Sandman6z/MVEPP_MainSensor/Doc/MVEPP_传感器接口定义.docx

O2 传感器接口定义

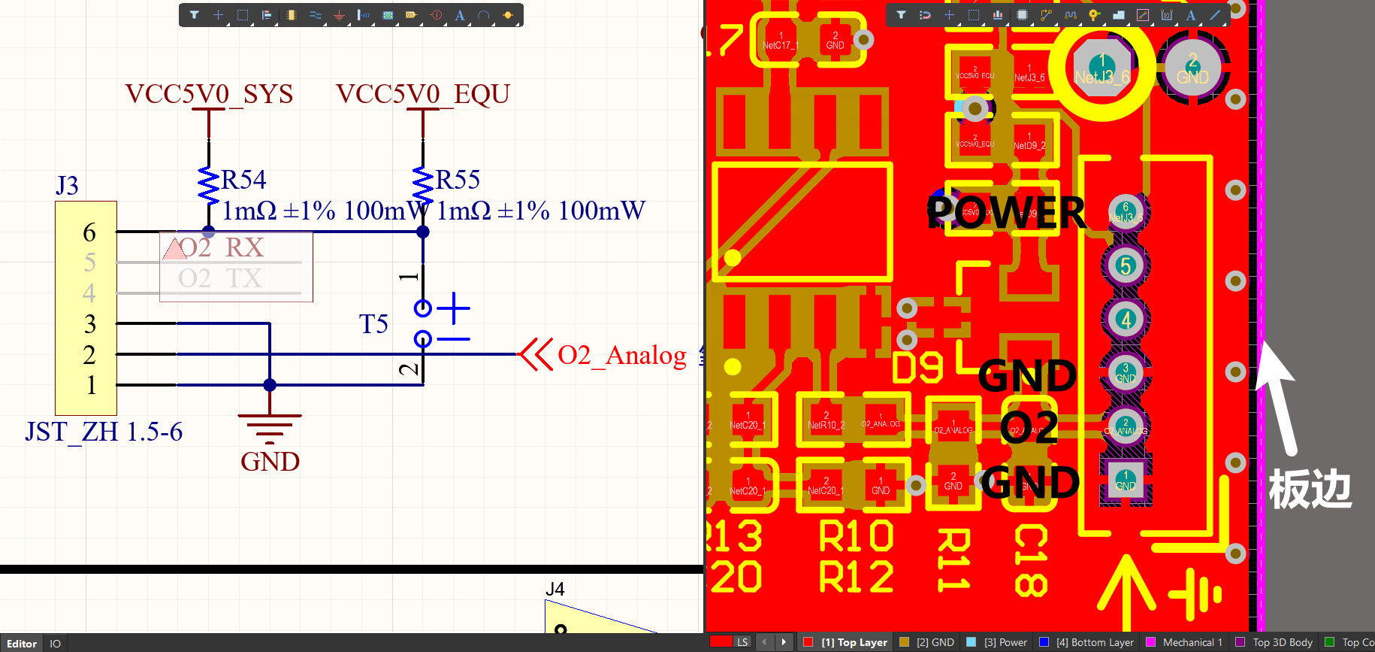
[picture p1: figure]

TSI

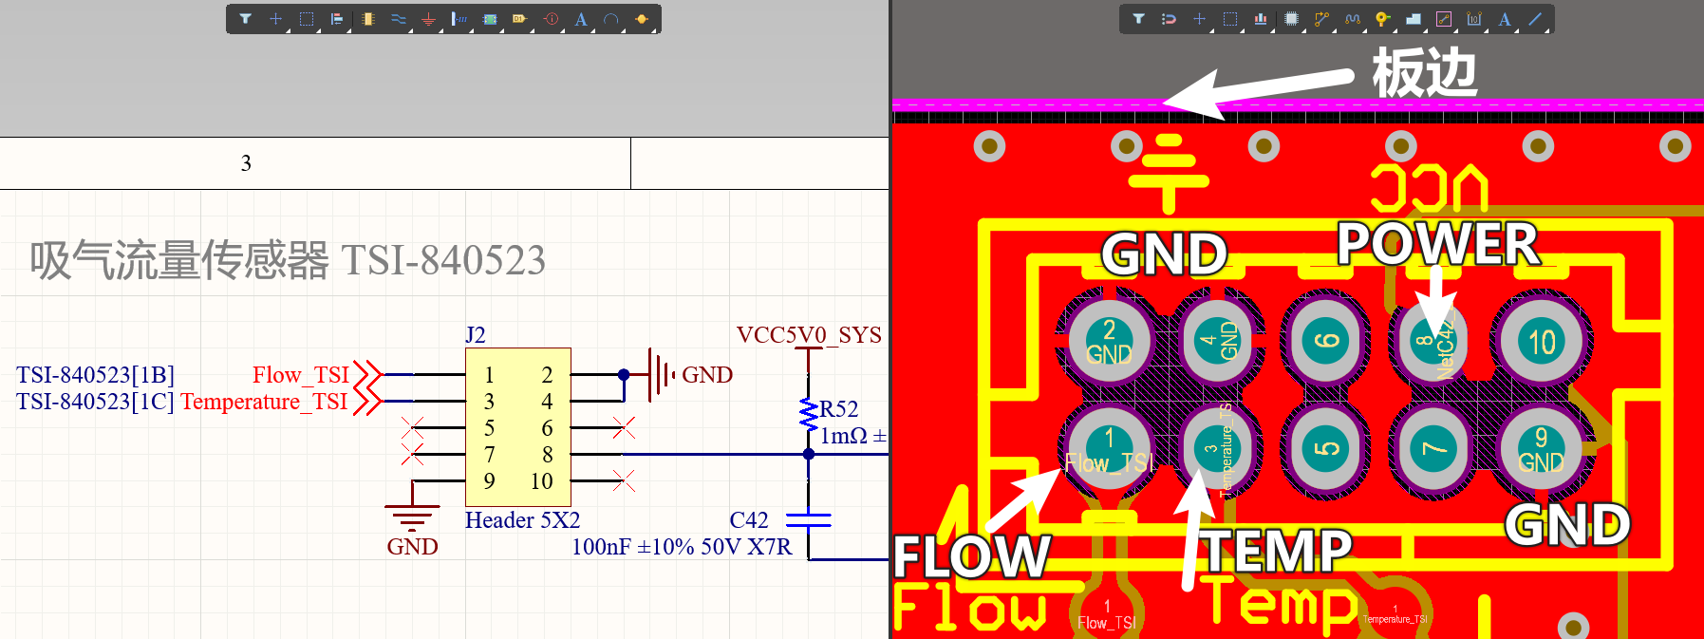
[picture p2: figure]

3100

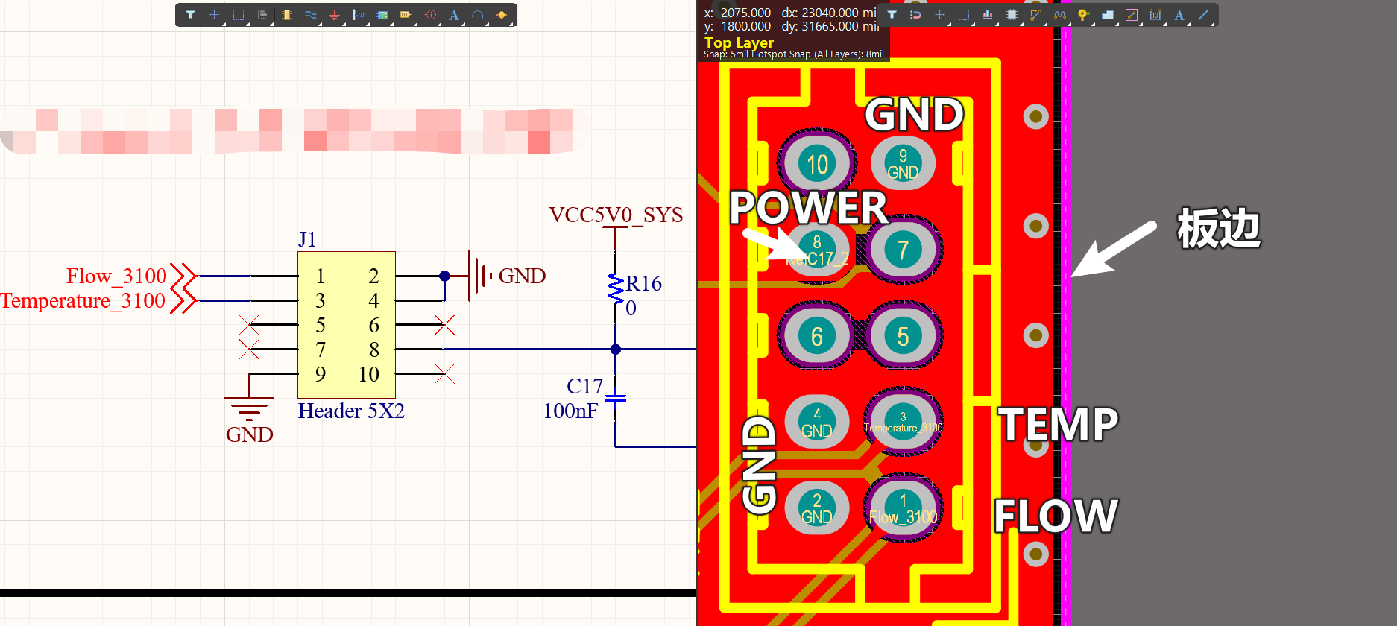
[picture p3: figure]
