Sandman6z/MVEPP_MainSensor/Doc/通气预研平台硬件设计-传感器物料编号.xlsx

元件编号 | 元件名称 | 元件型号 | 物料号 | 数量(单套) | 需申领数量
1 | 氧流量传感器 | SFM-3100 | 240001459 | 1 | 1*2
2 | 氧浓度传感器 | MOX-4 | 210001975 | 1 | 1*2
3 | 低压压力传感器 | HoneyWell-HSCDRRN160MDAA5 | 210004934 | 3 | 3*2
4 | 流量传感器 | TSI-8405xx | 452005747 | 1 | 1*2
5 | 微压差传感器 | HoneyWell-HSCDRRN002NGAA5 | 210004197 | 1 | 0
6 | 环境压力传感器 | MPXHZ6115AC6U | 210001798 | 1 | 1*2
7 | 高压压力传感器 | HoneyWell-ABPLLNT010BGAA5 | 210004930 | 1 | 0
