Sandman6z/MVEPP_MainSensor/(list of files, drawings)

Other design files:
452007098_MVEPP主传感器板.PrjPcb
IO.SchDoc
LED.SchDoc
Others.SchDoc
OxygenSensor.SchDoc
Power&Vref.SchDoc
PressSensor1.SchDoc
PressSensor2.SchDoc
Top.SchDoc
TSI-840523.SchDoc
框图.SchDoc
