Sandman6z/MVEPP_MainSensor/(commit log)

2024-04-26 Original files.
    [452006257#BDU控制板0-框图.SchDoc, 452006257#BDU控制板1-电源.SchDoc, 452006257#BDU控制板2-单片机.SchDoc, 452006257#BDU控制板3-功能安全.SchDoc, 452006257#BDU控制板4-通讯接口.SchDoc, 452006257#BDU控制板5-传感器.SchDoc, 452006257#BDU控制板6-传感器及外部AD.SchDoc, 452006257#BDU控制板7-执行部件.SchDoc]
2024-04-26 adjust files
    [452006257#BDU控制板1-电源.SchDoc, 452006257#BDU控制板2-单片机.SchDoc, 452006257#BDU控制板3-功能安全.SchDoc, 452006257#BDU控制板4-通讯接口.SchDoc, 452006257#BDU控制板5-传感器.SchDoc, 452006257#BDU控制板PCBA.PrjPcb, 压力传感器.SchDoc, 基准.SchDoc]
2024-04-29 adjust part of request
    [452006257#BDU控制板1-电源.SchDoc, 452006257#BDU控制板4-通讯接口.SchDoc, 452006257#BDU控制板5-传感器.SchDoc, 452006257#BDU控制板6-传感器及外部AD.SchDoc, 452006257#BDU控制板7-执行部件.SchDoc, 452006257#BDU控制板PCBA.PrjPcb, 基准.SchDoc, 氧传感器.SchDoc]
2024-04-30 adjust part
    [452006257#BDU控制板1-电源.SchDoc, 452006257#BDU控制板4-通讯接口.SchDoc, 452006257#BDU控制板6-传感器及外部AD.SchDoc, TSI-840523.SchDoc, 基准.SchDoc, 氧传感器.SchDoc, 氧浓度传感器.SchDoc, 电源及基准.SchDoc]
2024-05-07 go on
    [452006257#BDU控制板1-电源.SchDoc, 452006257#BDU控制板2-单片机.SchDoc, 452006257#BDU控制板3-功能安全.SchDoc, 452006257#BDU控制板4-通讯接口.SchDoc, 452006257#BDU控制板5-传感器.SchDoc, 452006257#BDU控制板6-传感器及外部AD.SchDoc, 452006257#BDU控制板7-执行部件.SchDoc, 452006257#BDU控制板PCBA.PrjPcb]
2024-05-10 Add new sheet to enlarge sensor
    [压力传感器.SchDoc]
2024-05-10 put block to beside
    [452006257#BDU控制板1-电源.SchDoc, 452006257#BDU控制板3-功能安全.SchDoc, 452006257#BDU控制板5-传感器.SchDoc, 452006257#BDU控制板6-传感器及外部AD.SchDoc, 452006257#BDU控制板PCBA.PrjPcb, IO.SchDoc, Others.SchDoc, Power&Vref.SchDoc]
2024-05-11 put all necessary part into the PCB
    [Power&Vref.SchDoc]
2024-05-20 del Vref LED, goon layout
    [452006257#BDU控制板PCBA.PrjPcb, Power&Vref.SchDoc]
2024-05-21 del GND test-PAD, led; add res to switch power
    [IO.SchDoc, Others.SchDoc, Power&Vref.SchDoc]
2024-05-22 ready to change PCB size
2024-05-22 almost finish design
    [452006257#BDU控制板PCBA.PrjPcb, IO.SchDoc, Power&Vref.SchDoc, TSI-840523.SchDoc, 压力传感器1.SchDoc, 压力传感器2.SchDoc, 氧浓度传感器.SchDoc]
2024-05-23 go on layout
    [IO.SchDoc, Others.SchDoc, Power&Vref.SchDoc]
2024-05-24 change POWER name & add resistor to different IC
    [452007098_MVEPP主传感器板.PrjPcb, IO.SchDoc, Power&Vref.SchDoc, TSI-840523.SchDoc, 压力传感器1.SchDoc, 压力传感器2.SchDoc, 氧浓度传感器.SchDoc]
2024-05-26 almost finish layout
    [452007098_MVEPP主传感器板.PrjPcb, Others.SchDoc, Power&Vref.SchDoc, 压力传感器1.SchDoc]
2024-05-27 finish layout, need to change silk
    [452006257#BDU控制板0-框图.SchDoc, 452006257#BDU控制板1-电源.SchDoc, 452006257#BDU控制板2-单片机.SchDoc, 452006257#BDU控制板3-功能安全.SchDoc, 452006257#BDU控制板4-通讯接口.SchDoc, 452006257#BDU控制板5-传感器.SchDoc, 452006257#BDU控制板6-传感器及外部AD.SchDoc, 452006257#BDU控制板7-执行部件.SchDoc]
2024-05-28 change layout
    [IO.SchDoc, TSI-840523.SchDoc, 压力传感器1.SchDoc, 压力传感器2.SchDoc, 氧浓度传感器.SchDoc]
2024-05-29 change component value
    [452007098_MVEPP主传感器板.PrjPcb, IO.SchDoc, Others.SchDoc, PCB.PcbLib, PCB1.PcbLib, Power&Vref.SchDoc]
2024-05-29 change component commit, create BOM file
    [452007098_MVEPP主传感器板.PrjPcb, IO.SchDoc, Others.SchDoc, Power&Vref.SchDoc, TSI-840523.SchDoc, 压力传感器1.SchDoc, 压力传感器2.SchDoc, 氧浓度传感器.SchDoc]
2024-06-03 adjust BOM
    [452007098_MVEPP主传感器板.PrjPcb, 452007098_MVEPP主传感器板.xlsx, IO.SchDoc, Power&Vref.SchDoc, TSI-840523.SchDoc, 压力传感器1.SchDoc, 压力传感器2.SchDoc, 氧浓度传感器.SchDoc]
2024-07-24 LM22676 EN cannot connect to anything. I short it to VIN, burn itgit add .! let EN pin floating
    [Power&Vref.SchDoc]
2024-07-24 connect VREF ESD tube pin 1 and 2, update the PCB
    [Power&Vref.SchDoc]
2024-07-29 use unlock file replace locked one
    [通气预研平台硬件设计-传感器物料编号.xlsx]
2024-08-01 add wire definition doc
    [452007098_MVEPP主传感器板.PrjPcb, MVEPP_J30J_PIN.xlsx]
2024-09-25 add port instead of offsheet
    [452007098_MVEPP主传感器板.PrjPcb, IO.SchDoc, LED.SchDoc, OxygenSensor.SchDoc, Power&Vref.SchDoc, PressSensor1.SchDoc, PressSensor2.SchDoc, TSI-840523.SchDoc]
2024-09-26 change Amplifier backup resistor
    [OxygenSensor.SchDoc, PressSensor1.SchDoc, PressSensor2.SchDoc, TSI-840523.SchDoc]
2024-09-29 Organize the structure and adjust the gaps
    [452007098_MVEPP主传感器板.PrjPcb, IO.SchDoc, LED.SchDoc, Others.SchDoc, PressSensor1.SchDoc, TSI-840523.SchDoc]
